1oEpalGeras/EggIncubator/pictures/DSC01368.JPG

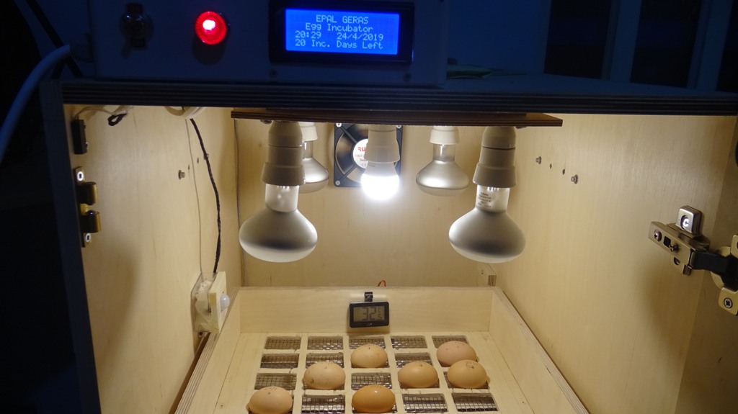
pictures/DSC01368.JPG
