1oEpalGeras/EggIncubator/Schematic Diagram.pdf

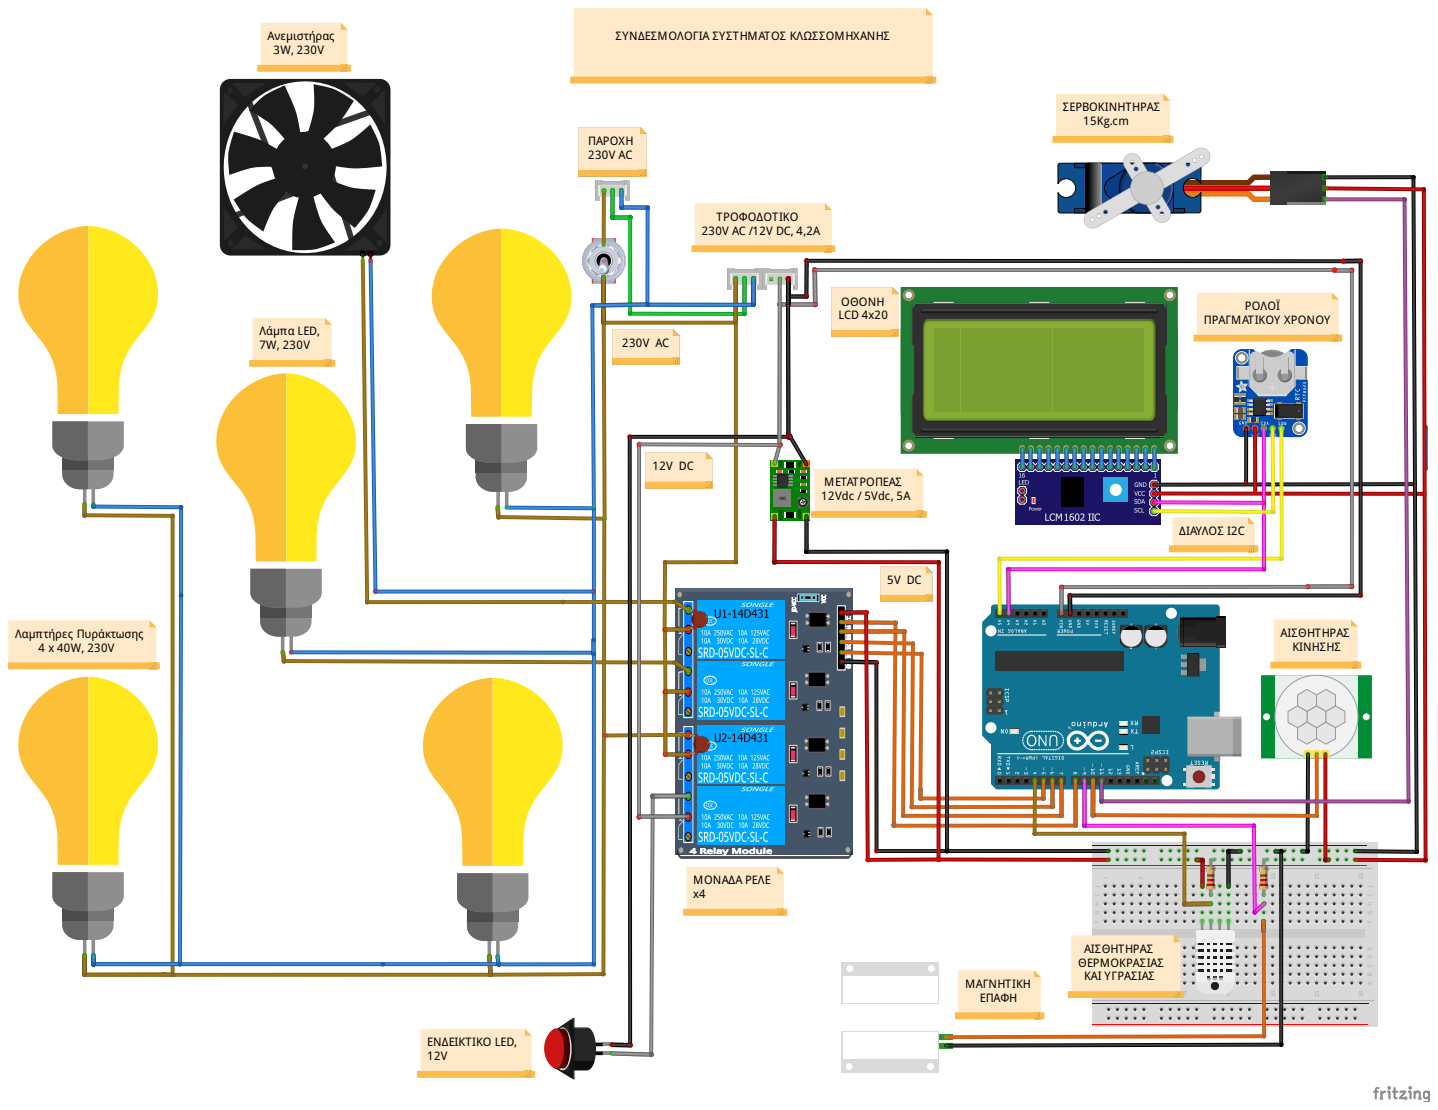
[picture p37: page 1]
ΤΡΟΦΟΔΟΤΙΚΟ 230V AC /12V DC, 4,2A; ΠΑΡΟΧΗ 230V AC; ΜΟΝΑΔΑ ΡΕΛΕ x4; ΔΙΑΥΛΟΣ I2C; ΑΙΣΘΗΤΗΡΑΣ ΘΕΡΜΟΚΡΑΣΙΑΣ ΚΑΙ ΥΓΡΑΣΙΑΣ; EΝΔΕΙΚΤΙΚΟ LED, 12V; ΡΟΛΟΪ ΠΡΑΓΜΑΤΙΚΟΥ ΧΡΟΝΟΥ; Aνεμιστήρας 3W, 230V; Λαμπτήρες Πυράκτωσης 4 x 40W, 230V; Λάμπα LED, 7W, 230V; ΟΘΟΝΗ LCD 4x20; ΣΕΡΒΟΚΙΝΗΤΗΡΑΣ 15Kg.cm; ΑΙΣΘΗΤΗΡΑΣ ΚΙΝΗΣΗΣ; ΜΑΓΝΗΤΙΚΗ ΕΠΑΦΗ; ΜΕΤΑΤΡΟΠΕΑΣ 12Vdc / 5Vdc, 5A

ΣΥΝΔΕΣΜΟΛΟΓΙΑ ΣΥΣΤΗΜΑΤΟΣ ΚΛΩΣΣΟΜΗΧΑΝΗΣ
